bismurphy/wifi_geiger/Kicad Project/Wifi_Geiger.kicad_pcb

## KiCad design Kicad Project/Wifi_Geiger.kicad_pcb (2020-11-04)

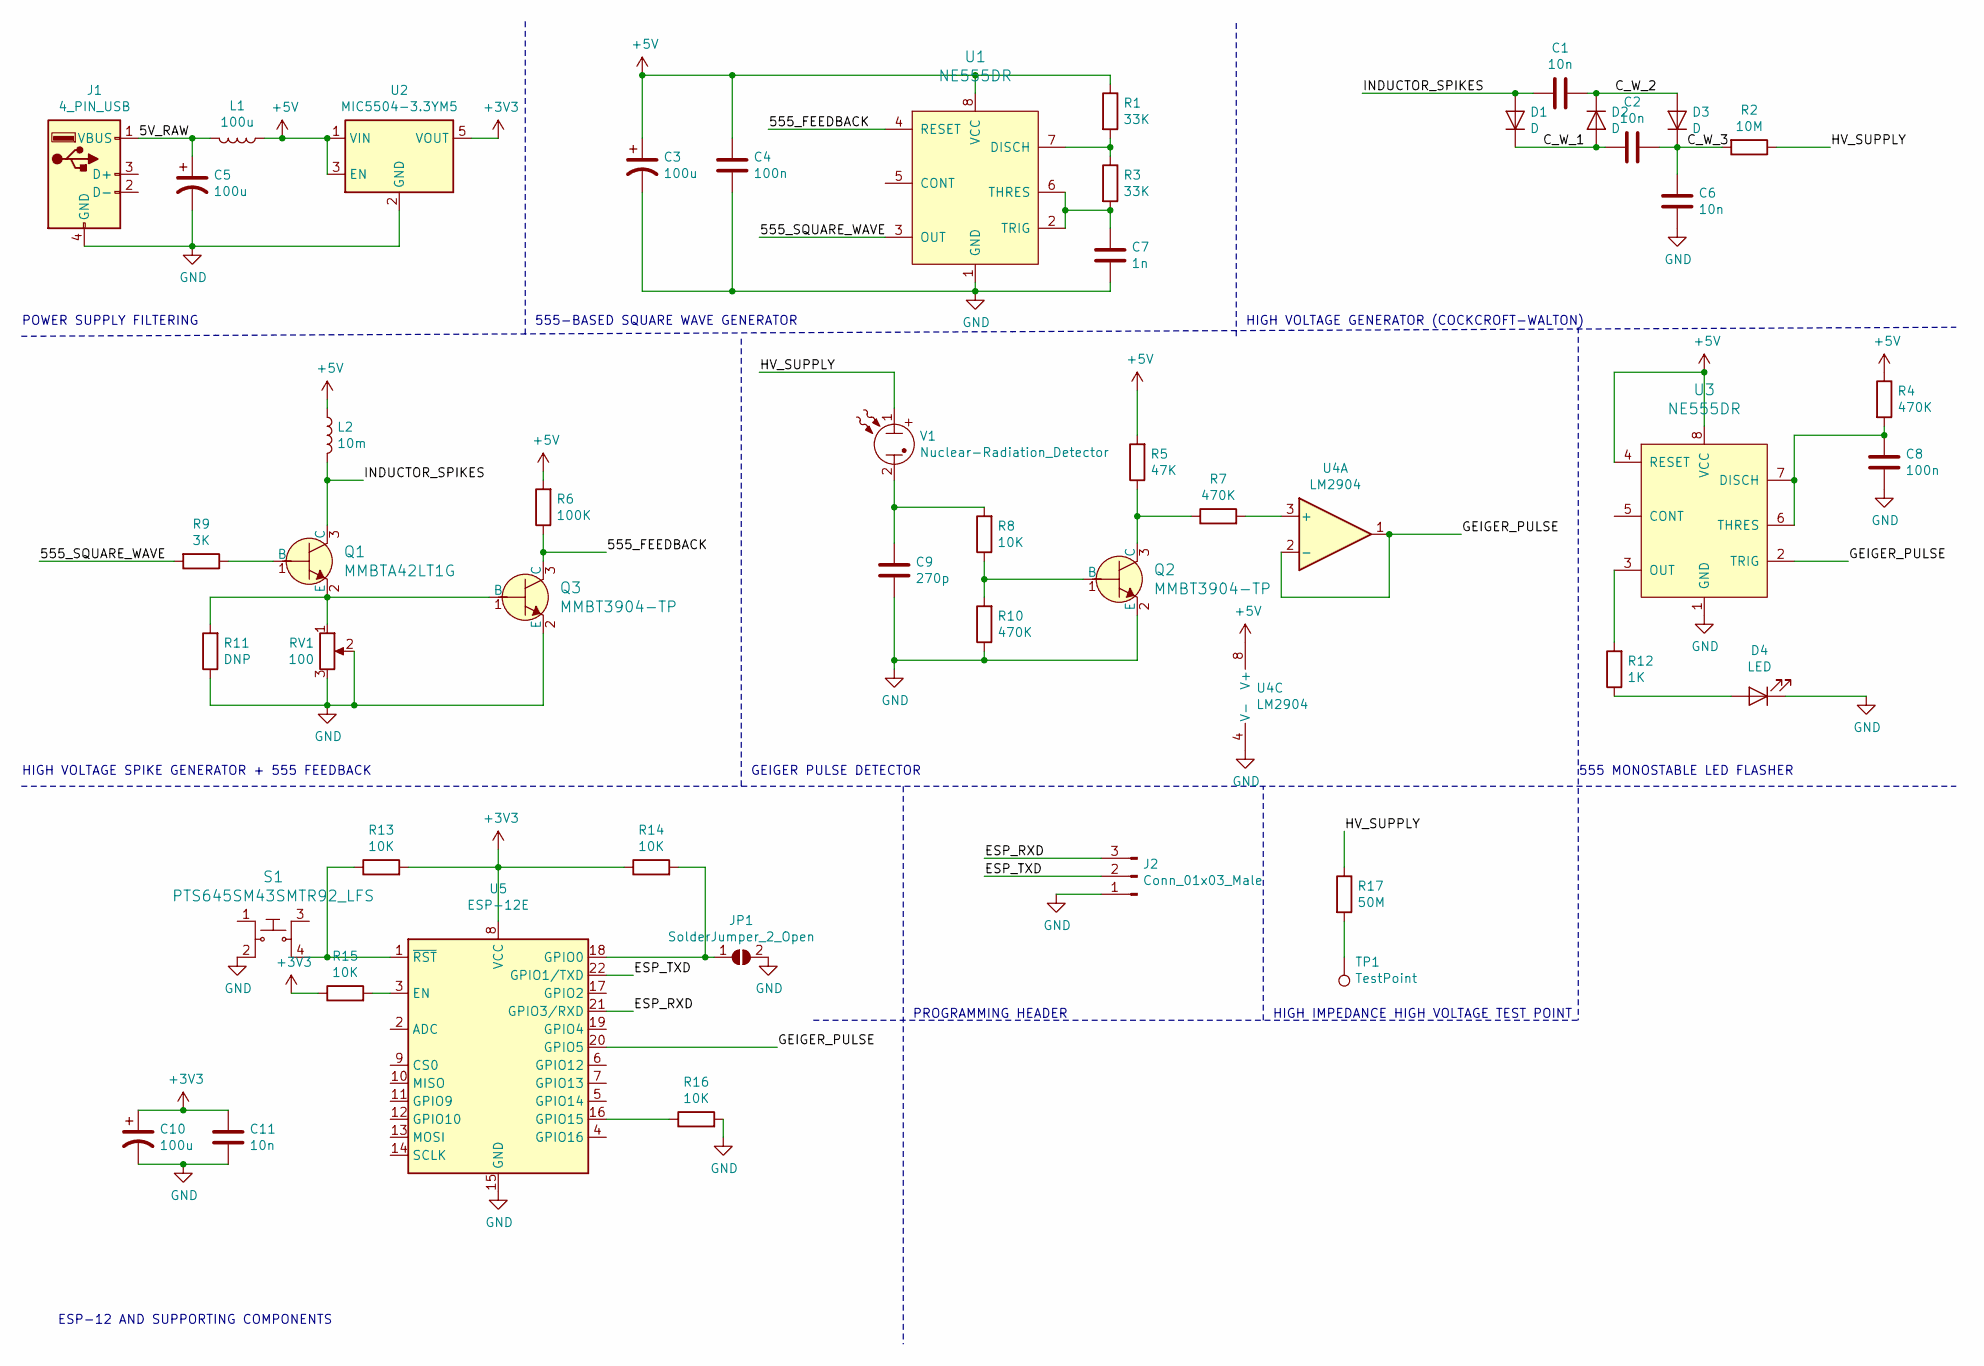
[picture p1: schematic Wifi_Geiger.sch]

Parts:
C1, C2, C6, C11: 10n; C_1206_3216Metric_Pad1.42x1.75mm_HandSolder
C3, C5, C10: 100u; CP_Elec_6.3x5.3
C4, C8: 100n; C_0603_1608Metric_Pad1.05x0.95mm_HandSolder
C7: 1n; C_0603_1608Metric_Pad1.05x0.95mm_HandSolder
C9: 270p; C_0603_1608Metric_Pad1.05x0.95mm_HandSolder
D1, D2, D3: D; D_SOD-123F
D4: LED; D_0603_1608Metric_Castellated
J1: 4_PIN_USB; usb-traces
J2: Conn_01x03_Male; PinHeader_1x03_P2.54mm_Vertical
JP1: SolderJumper_2_Open; SolderJumper-2_P1.3mm_Open_RoundedPad1.0x1.5mm
L1: 100u; L_0805_2012Metric_Pad1.15x1.40mm_HandSolder
L2: 10m; L_Bourns_SRR1210A
Q1: MMBTA42LT1G; SOT-23-3; MPN MMBTA42LT1G; Digi-Key_PN MMBTA42LT1GOSCT-ND
Q2, Q3: MMBT3904-TP; SOT-23-3; MPN MMBT3904-TP; Digi-Key_PN MMBT3904TPMSCT-ND
R1, R3: 33K; R_0603_1608Metric_Pad1.05x0.95mm_HandSolder
R2: 10M; R_0603_1608Metric_Pad1.05x0.95mm_HandSolder
R4, R7, R10: 470K; R_0603_1608Metric_Pad1.05x0.95mm_HandSolder
R5: 47K; R_0603_1608Metric_Pad1.05x0.95mm_HandSolder
R6: 100K; R_0603_1608Metric_Pad1.05x0.95mm_HandSolder
R8, R13, R14, R15, R16: 10K; R_0603_1608Metric_Pad1.05x0.95mm_HandSolder
R9: 3K; R_0603_1608Metric_Pad1.05x0.95mm_HandSolder
R11: DNP; R_0603_1608Metric_Pad1.05x0.95mm_HandSolder
R12: 1K; R_0603_1608Metric_Pad1.05x0.95mm_HandSolder
R17: 50M; R_0603_1608Metric_Pad1.05x0.95mm_HandSolder
RV1: 100; Potentiometer_Bourns_TC33X_Vertical
S1: PTS645SM43SMTR92_LFS; Switch_Tactile_SMD_6x6mm_PTS645; MPN PTS645SM43SMTR92 LFS; Digi-Key_PN CKN9112CT-ND
TP1: TestPoint; TestPoint_Pad_D2.5mm
U1, U3: NE555DR; SOIC-8_W3.9mm; MPN NE555DR; Digi-Key_PN 296-6501-1-ND
U2: MIC5504-3.3YM5; SOT-23-5
U4: LM2904; SOIC-8_3.9x4.9mm_P1.27mm
U5: ESP-12E
V1: Nuclear-Radiation_Detector; j305_geiger_fuse_holder

Connections:
+3V3: C10.1, C11.2, R13.2, R14.1, R15.1, U2.5 (VOUT), U5.8 (VCC)
+5V: C3.1, C4.1, L1.1, L2.1, R1.1, R4.1, R5.2, R6.2, U1.8 (VCC), U2.1 (VIN), U2.3 (EN), U3.4 (RESET), U3.8 (VCC), U4.8 (V+)
/5V_RAW: C5.1, J1.1 (VBUS), L1.2
/555_FEEDBACK: Q3.3 (C), R6.1, U1.4 (RESET)
/555_SQUARE_WAVE: R9.2, U1.3 (OUT)
/C_W_1: C2.2, D1.1 (K), D2.2 (A)
/C_W_2: C1.1, D2.1 (K), D3.2 (A)
/C_W_3: C2.1, C6.2, D3.1 (K), R2.2
/ESP_RXD: J2.3, U5.21 (GPIO3/RXD)
/ESP_TXD: J2.2, U5.22 (GPIO1/TXD)
/GEIGER_PULSE: U3.2 (TRIG), U4.1, U4.2 (-), U5.20 (GPIO5)
/HV_SUPPLY: R2.1, R17.1, V1.1
/INDUCTOR_SPIKES: C1.2, D1.2 (A), L2.2, Q1.3 (C)
GND: C3.2, C4.2, C5.2, C6.1, C7.2, C8.2, C9.1, C10.2, C11.1, D4.1 (K), J1.4 (GND), J2.1, JP1.2 (B), Q2.2 (E), Q3.2 (E), R10.1, R11.1, R16.2, RV1.2, RV1.3, S1.2, U1.1 (GND), U2.2 (GND), U3.1 (GND), U4.4 (V-), U5.15 (GND)
unnamed: C7.1, R3.2, U1.2 (TRIG), U1.6 (THRES)
unnamed: C8.1, R4.2, U3.6 (THRES), U3.7 (DISCH)
unnamed: C9.2, R8.2, V1.2
unnamed: D4.2 (A), R12.1
unnamed: JP1.1 (A), R14.2, U5.18 (GPIO0)
unnamed: Q1.1 (B), R9.1
unnamed: Q1.2 (E), Q3.1 (B), R11.2, RV1.1
unnamed: Q2.1 (B), R8.1, R10.2
unnamed: Q2.3 (C), R5.1, R7.1
unnamed: R1.2, R3.1, U1.7 (DISCH)
unnamed: R7.2, U4.3 (+)
unnamed: R12.2, U3.3 (OUT)
unnamed: R13.1, S1.4, U5.1 (~RST)
unnamed: R15.2, U5.3 (EN)
unnamed: R16.1, U5.16 (GPIO15)
unnamed: R17.2, TP1.1

Notes on the sheet:
POWER SUPPLY FILTERING
555-BASED SQUARE WAVE GENERATOR
HIGH VOLTAGE SPIKE GENERATOR + 555 FEEDBACK
HIGH VOLTAGE GENERATOR (COCKCROFT-WALTON)
GEIGER PULSE DETECTOR
555 MONOSTABLE LED FLASHER
ESP-12 AND SUPPORTING COMPONENTS
PROGRAMMING HEADER
HIGH IMPEDANCE HIGH VOLTAGE TEST POINT

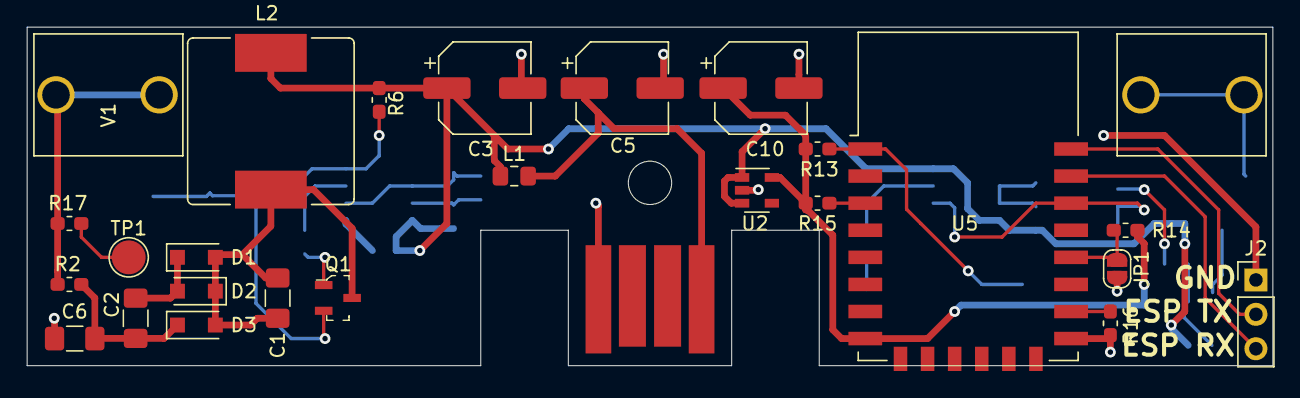
[picture p2: board Wifi_Geiger.kicad_pcb from above]

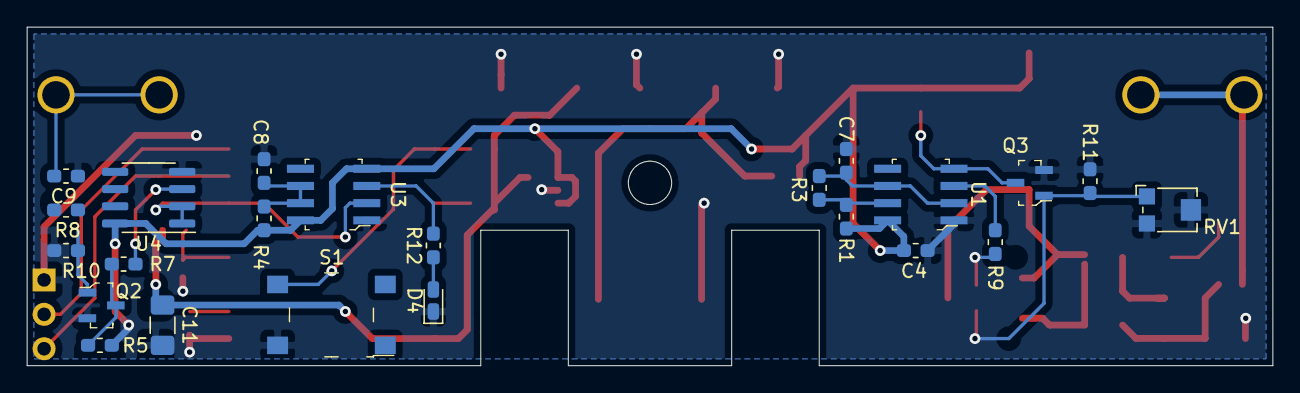
[picture p3: board Wifi_Geiger.kicad_pcb from below]

Board: 2 copper layers, 92.0 x 25.0 mm, 49 parts (23 on the bottom side), 30 nets.
