bismurphy/wifi_geiger/(commit log)

2020-09-28 Added software in the state it was in on the initial prototype
2020-09-28 Arduino IDE needed slight folder reconfig
2020-11-04 Final commit for video
    [Wifi_Geiger.kicad_pcb, Wifi_Geiger.sch]
